fwachsmuth/ErnoCCC/Schematics/MCP4725.png

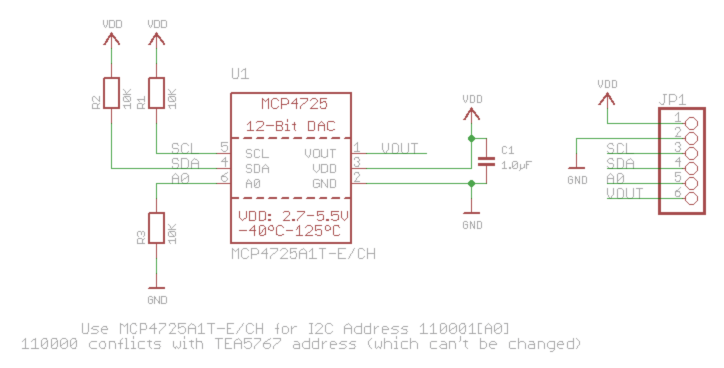
Schematics/MCP4725.png
