fwachsmuth/ErnoCCC/ErnoCCC-Kicad/ErnoCCC.kicad_pcb

## KiCad design ErnoCCC-Kicad/ErnoCCC.kicad_pcb (2023-11-20)

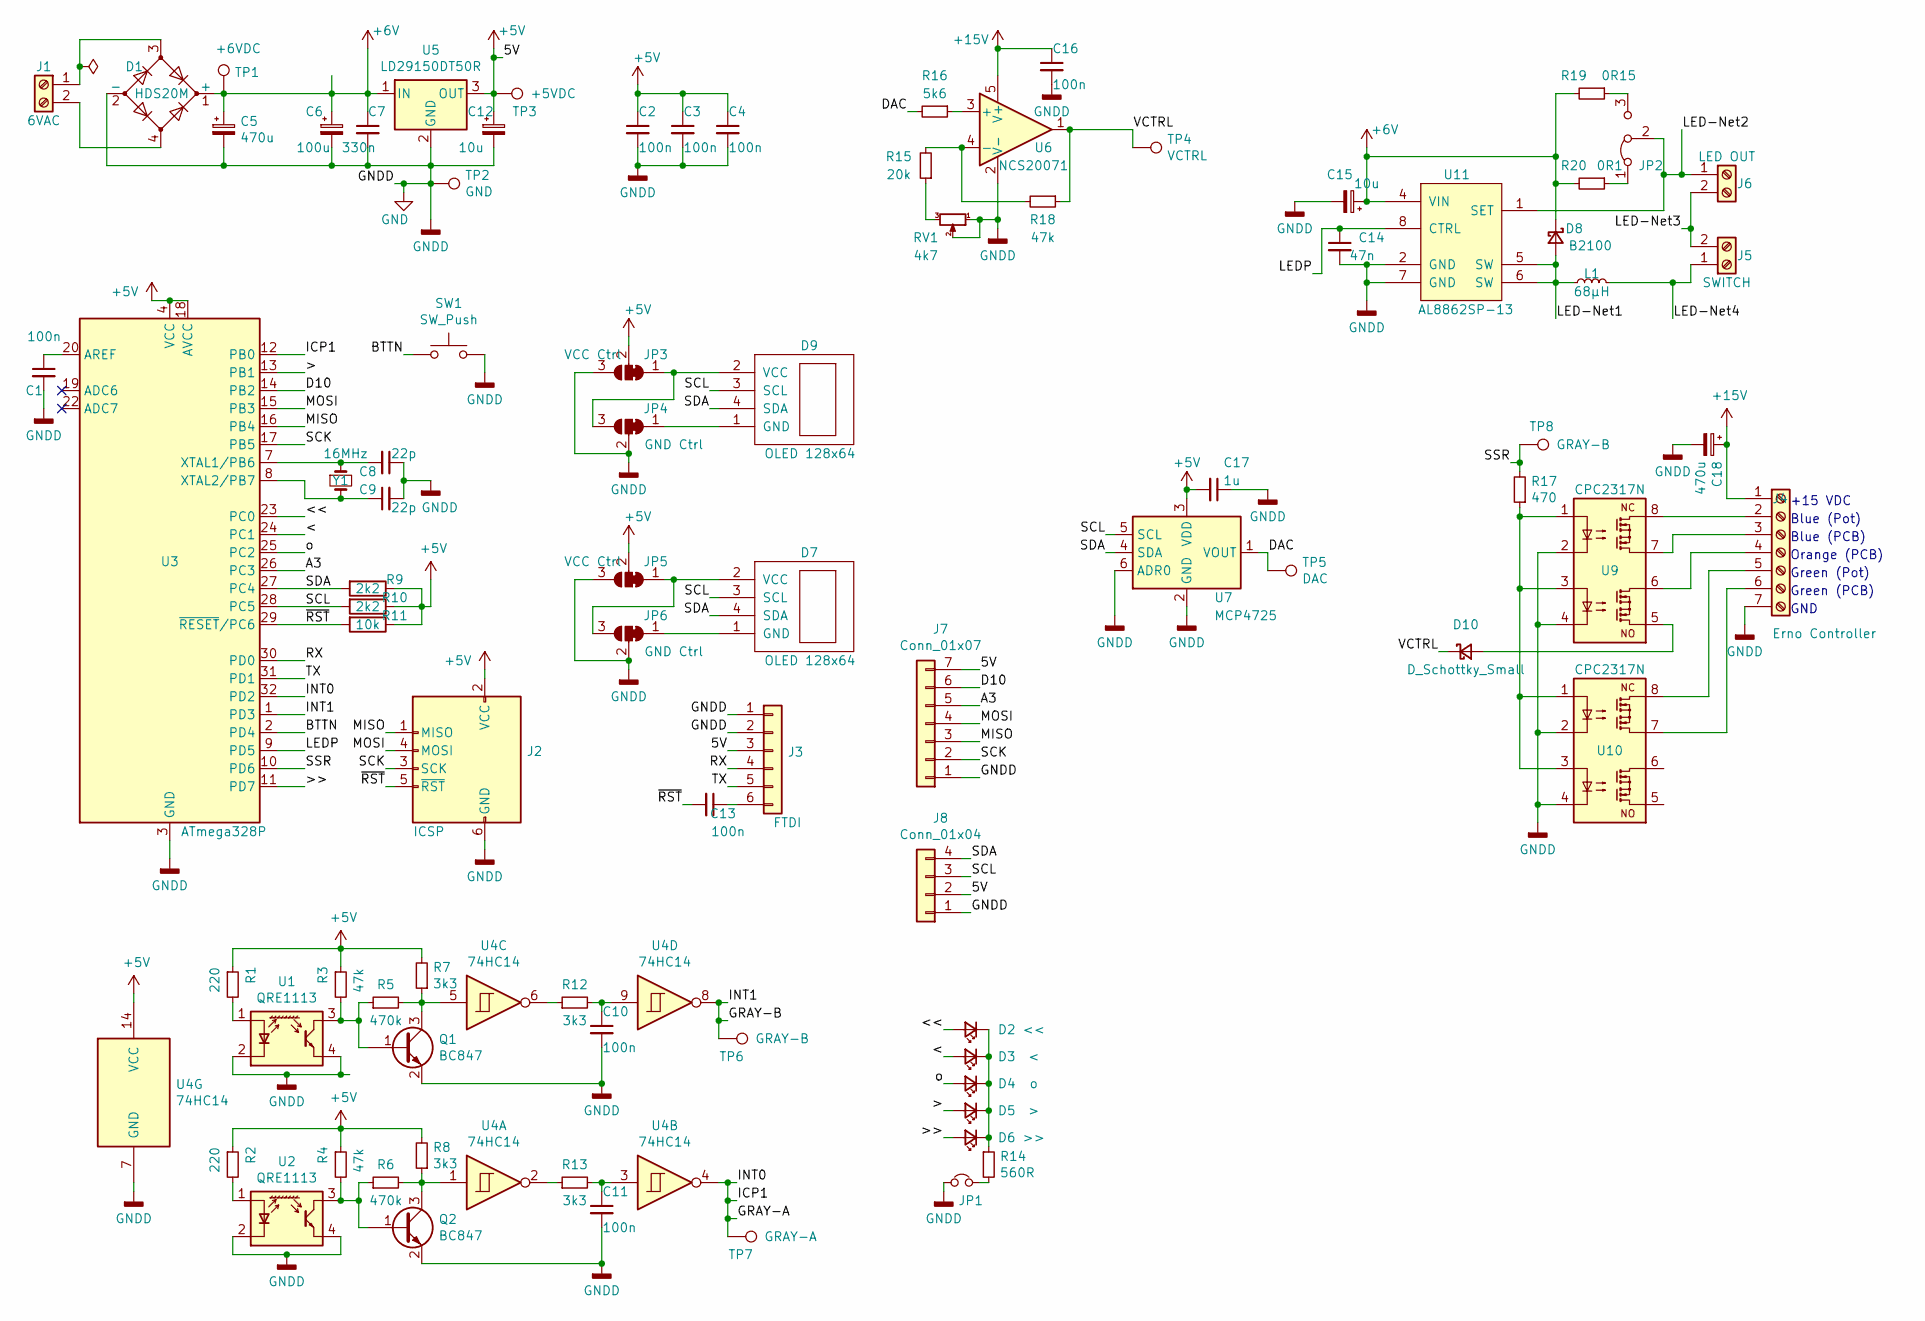
[picture p2: schematic ErnoCCC.kicad_sch]

Parts:
C1, C2, C3, C4, C10, C11, C13, C16: 100n; C_0805_2012Metric
C5, C18: 470u; CP_Elec_10x10
C6: 100u; CP_Elec_8x10.5
C7: 330n; C_0805_2012Metric
C8, C9: 22p; C_0805_2012Metric
C12, C15: 10u; CP_Elec_4x4.5
C14: 47n; C_0805_2012Metric
C17: 1u; C_0805_2012Metric
D1: HDS20M; HDS-4
D2: <<; LED_0805_2012Metric_Castellated
D3: <; LED_0805_2012Metric_Castellated
D4: o; LED_0805_2012Metric_Castellated
D5: >; LED_0805_2012Metric_Castellated
D6: >>; LED_0805_2012Metric_Castellated
D7: OLED 128x64; PinHeader_1x04_P2.54mm_Vertical
D8: B2100; D_SMB
D9: OLED 128x64; PinHeader_1x04_P2.54mm_Horizontal_shorter
D10: D_Schottky_Small; D_SMB
J1: 6VAC; TerminalBlock_bornier-2_P5.08mm
J2: ICSP; PinHeader_2x03_P2.54mm_Vertical
J3: FTDI; PinHeader_1x06_P2.54mm_Horizontal_shorter
J4: Erno Controller; TerminalBlock_Phoenix_MPT-0,5-7-2.54_1x07_P2.54mm_Horizontal
J5: SWITCH; TerminalBlock_bornier-2_P5.08mm
J6: LED OUT; TerminalBlock_bornier-2_P5.08mm
J7: Conn_01x07; PinSocket_1x07_P2.54mm_Vertical
J8: Conn_01x04; PinHeader_1x04_P2.54mm_Vertical
JP1: LED Jumper; PinHeader_1x03_P2.54mm_Vertical
JP2: R1 Select; SolderJumper-3_P1.3mm_Bridged2Bar12_Pad1.0x1.5mm
JP3, JP5: VCC Ctrl; SolderJumper-3_P1.3mm_Bridged12_RoundedPad1.0x1.5mm
JP4, JP6: GND Ctrl; SolderJumper-3_P1.3mm_Bridged12_RoundedPad1.0x1.5mm
L1: 68µH; L_10.4x10.4_H4.8
Q1, Q2: BC847; SOT-23
R1, R2: 220; R_0805_2012Metric
R3, R4, R18: 47k; R_0805_2012Metric
R5, R6: 470k; R_0805_2012Metric
R7, R8, R12, R13: 3k3; R_0805_2012Metric
R9, R10: 2k2; R_0805_2012Metric
R11: 10k; R_0805_2012Metric
R14: 560R; R_0805_2012Metric
R15: 20k; R_0805_2012Metric
R16: 5k6; R_0805_2012Metric
R17: 470; R_0805_2012Metric
R19: 0R15; R_1210_3225Metric
R20: 0R1; R_1210_3225Metric
RV1: 4k7; Potentiometer_Bourns_3296W_Vertical
SW1: SW_Push; SW_PUSH_6mm_H7.3mm
TP1: +6VDC; TestPoint_THTPad_D1.5mm_Drill0.7mm
TP2: GND; TestPoint_THTPad_2.0x2.0mm_Drill1.0mm
TP3: +5VDC; TestPoint_THTPad_D1.5mm_Drill0.7mm
TP4: VCTRL; TestPoint_THTPad_1.5x1.5mm_Drill0.7mm
TP5: DAC; TestPoint_THTPad_1.5x1.5mm_Drill0.7mm
TP6, TP8: GRAY-B; TestPoint_THTPad_1.5x1.5mm_Drill0.7mm
TP7: GRAY-A; TestPoint_THTPad_1.5x1.5mm_Drill0.7mm
U1, U2: QRE1113; QRE1113GR-slim
U3: ATmega328P; TQFP-32_7x7mm_P0.8mm
U4: 74HC14; SOIC-14_3.9x8.7mm_P1.27mm
U5: LD29150DT50R; TO-252-2
U6: NCS20071; TSOT-23-5
U7: MCP4725; SOT-23-6
U9, U10: CPC2317N; SOIC-8
U11: AL8862SP-13; SOIC-8-1EP_3.9x4.9mm_P1.27mm_EP2.41x3.81mm_ThermalVias
Y1: 16MHz; Crystal_SMD_Abracon_ABM3-2Pin_5.0x3.2mm

Connections:
+5V: C2.1, C3.1, C4.1, C12.1, C17.2, J2.2 (VCC), J3.3, J7.7, J8.2, JP3.2 (C), JP5.2 (C), R1.1, R2.1, R3.1, R4.1, R7.2, R8.2, R9.1, R10.1, R11.1, TP3.1, U3.4 (VCC), U3.6 (VCC), U3.18 (AVCC), U4.14 (VCC), U5.3 (OUT), U7.3 (VDD)
+6V: C5.1, C6.1, C7.1, C15.1, D1.1 (+), D8.1 (K), R19.2, R20.2, TP1.1, U5.1 (IN), U11.4 (VIN)
+15V: C16.1, C18.1, J4.1, U6.5 (V+)
/<: D3.2 (A), U3.24 (PC1)
/<<: D2.2 (A), U3.23 (PC0)
/>: D5.2 (A), U3.13 (PB1)
/>>: D6.2 (A), U3.11 (PD7)
/A3: J7.5, U3.26 (PC3)
/BTTN: SW1.1, U3.2 (PD4)
/D10: J7.6, U3.14 (PB2)
/DAC: R16.2, TP5.1, U7.1 (VOUT)
/GRAY-A: TP7.1, U3.12 (PB0), U3.32 (PD2), U4.4
/GRAY-B: TP6.1, U3.1 (PD3), U4.8
/LED-Net1: D8.2 (A), L1.1, U11.5 (SW), U11.6 (SW)
/LED-Net2: J6.1, JP2.2 (C), U11.1 (SET)
/LED-Net3: J5.2, J6.2
/LED-Net4: J5.1, L1.2
/LEDP: C14.1, U3.9 (PD5), U11.8 (CTRL)
/MISO: J2.1 (MISO), J7.3, U3.16 (PB4)
/MOSI: J2.4 (MOSI), J7.4, U3.15 (PB3)
/RX: J3.4, U3.30 (PD0)
/SCK: J2.3 (SCK), J7.2, U3.17 (PB5)
/SCL: D7.3 (SCL), D9.3 (SCL), J8.3, R10.2, U3.28 (PC5), U7.5 (SCL)
/SDA: D7.4 (SDA), D9.4 (SDA), J8.4, R9.2, U3.27 (PC4), U7.4 (SDA)
/SSR: R17.2, TP8.1, U3.10 (PD6)
/TX: J3.5, U3.31 (PD1)
/VCTRL: D10.1 (K), R18.1, TP4.1, U6.1
/o: D4.2 (A), U3.25 (PC2)
/~RST: C13.2, J2.5 (~RST), R11.2, U3.29 (~RESET/PC6)
GND: C1.2, C2.2, C3.2, C4.2, C5.2, C6.2, C7.2, C8.1, C9.2, C10.2, C11.2, C12.2, C14.2, C15.2, C16.2, C17.1, C18.2, D1.2 (-), J2.6 (GND), J3.1, J3.2, J4.7, J7.1, J8.1, JP1.1, JP3.3 (B), JP4.2 (C), JP5.3 (B), JP6.2 (C), Q1.2 (E), Q2.2 (E), RV1.1, RV1.2, SW1.2, TP2.1, U1.2 (K), U1.4, U2.2 (K), U2.4, U3.3 (GND), U3.5 (GND), U3.21 (GND), U4.7 (GND), U5.2 (GND), U6.2 (V-), U7.2 (GND), U7.6 (ADR0), U9.2, U9.4, U10.2, U10.4, U11.2 (GND), U11.7 (GND)
unnamed: C1.1, U3.20 (AREF)
unnamed: C8.2, U3.7 (XTAL1/PB6), Y1.1
unnamed: C9.1, U3.8 (XTAL2/PB7), Y1.2
unnamed: C10.1, R12.2, U4.9
unnamed: C11.1, R13.2, U4.3
unnamed: C13.1, J3.6
unnamed: D1.3, J1.1
unnamed: D1.4, J1.2
unnamed: D2.1 (K), D3.1 (K), D4.1 (K), D5.1 (K), D6.1 (K), R14.1
unnamed: D7.1 (GND), JP6.1 (A)
unnamed: D7.2 (VCC), JP5.1 (A), JP6.3 (B)
unnamed: D9.1 (GND), JP4.1 (A)
unnamed: D9.2 (VCC), JP3.1 (A), JP4.3 (B)
unnamed: D10.2 (A), U9.5
unnamed: J4.2, U9.8
unnamed: J4.3, U9.7
unnamed: J4.4, U9.6
unnamed: J4.5, U10.8
unnamed: J4.6, U10.7
unnamed: JP1.2, R14.2
unnamed: JP2.1 (A), R20.1
unnamed: JP2.3 (B), R19.1
unnamed: Q1.1 (B), R3.2, R5.1, U1.3
unnamed: Q1.3 (C), R5.2, R7.1, U4.5
unnamed: Q2.1 (B), R4.2, R6.1, U2.3
unnamed: Q2.3 (C), R6.2, R8.1, U4.1
unnamed: R1.2, U1.1 (A)
unnamed: R2.2, U2.1 (A)
unnamed: R12.1, U4.6
unnamed: R13.1, U4.2
unnamed: R15.1, RV1.3
unnamed: R15.2, R18.2, U6.4 (-)
unnamed: R16.1, U6.3 (+)
unnamed: R17.1, U9.1, U9.3, U10.1, U10.3

Notes on the sheet:
GND
+15 VDC
Green (PCB)
Blue (Pot)
Green (Pot)
Orange (PCB)
Blue (PCB)

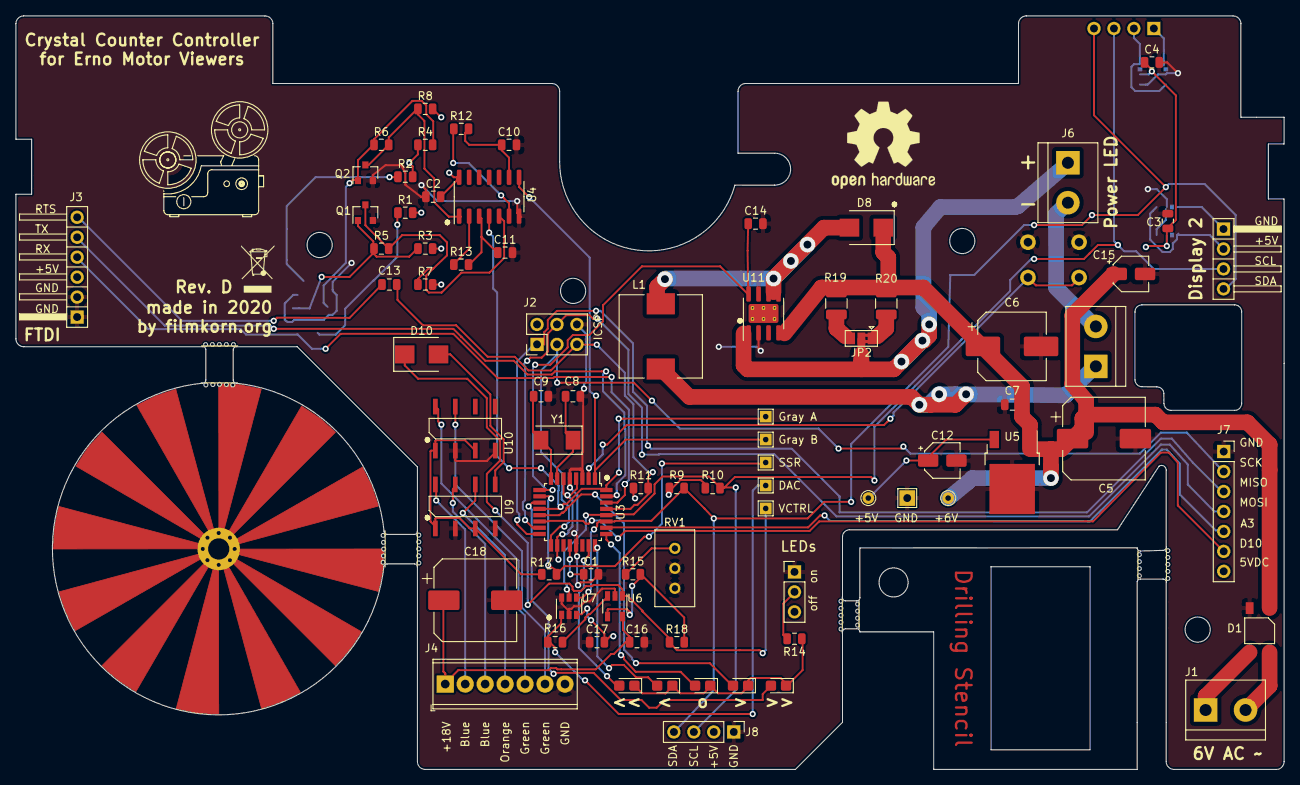
[picture p3: board ErnoCCC.kicad_pcb from above]

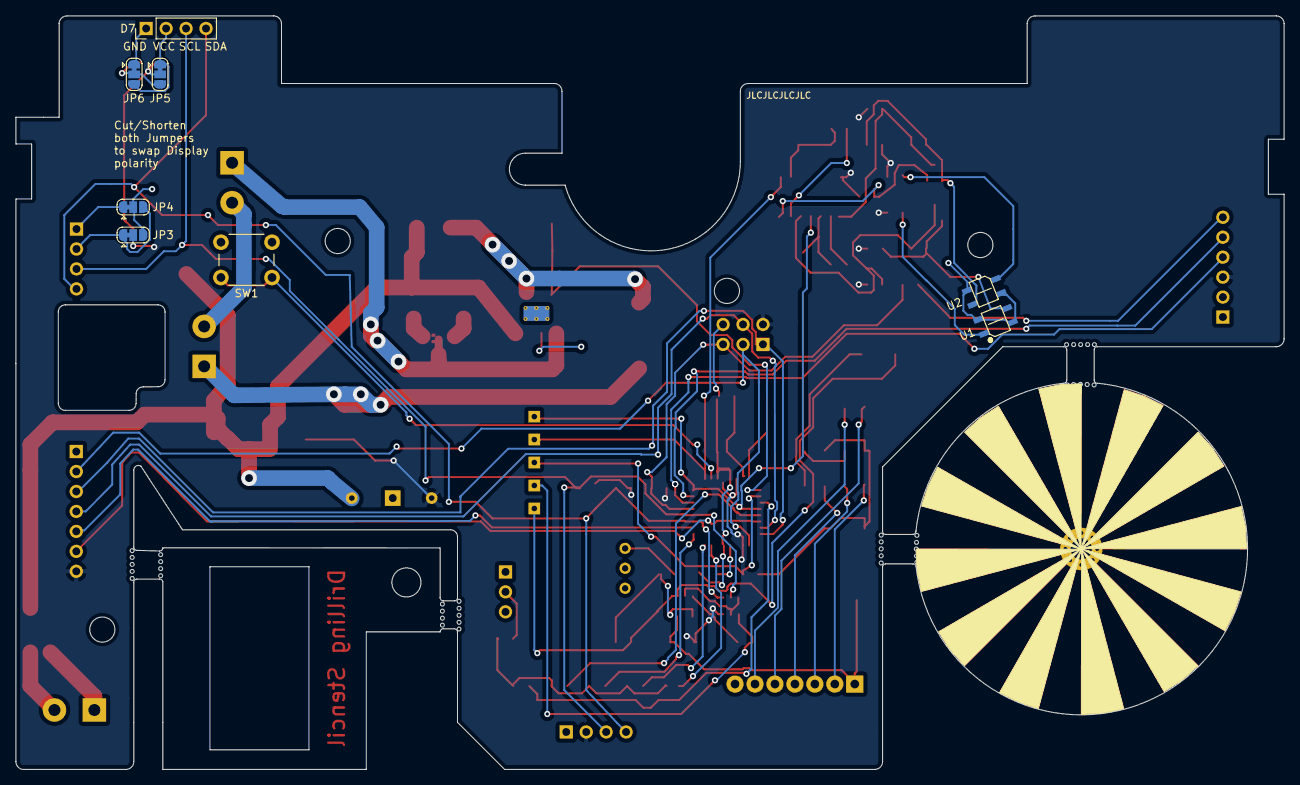
[picture p4: board ErnoCCC.kicad_pcb from below]

Board: 2 copper layers, 161.4 x 95.9 mm, 86 parts (8 on the bottom side), 64 nets.
