fwachsmuth/ErnoCCC/(commit log)

2019-12-28 KiCad Project
    [ErnoCCC.kicad_pcb, ErnoCCC.sch]
2019-12-28 Cleaning up Dir Structure
    [ErnoCCC.kicad_pcb, ErnoCCC.sch]
2019-12-29 Gerbers for Rev A
    [ErnoCCC-B_Cu.gbr, ErnoCCC-B_Mask.gbr, ErnoCCC-B_Paste.gbr, ErnoCCC-B_SilkS.gbr, ErnoCCC-Edge_Cuts.gbr, ErnoCCC-F_Cu.gbr, ErnoCCC-F_Mask.gbr, ErnoCCC-F_Paste.gbr]
2019-12-29 Cleaning up Kicad
    [ErnoCCC.sch]
2019-12-30 Adding a D10 Breakout for later Vectrol (or MOSFET) experiments
    [ErnoCCC.kicad_pcb, ErnoCCC.sch]
2019-12-30 Adding TPs to a Header, fixing disconnected GND planes
    [ErnoCCC-B_Cu.gbr, ErnoCCC-B_Mask.gbr, ErnoCCC-B_Paste.gbr, ErnoCCC-B_SilkS.gbr, ErnoCCC-Edge_Cuts.gbr, ErnoCCC-F_Cu.gbr, ErnoCCC-F_Mask.gbr, ErnoCCC-F_Paste.gbr]
2019-12-30 Create a little jittering GRAY-Code Generator to simulate viewer movenment
    [CreateGray.ino, ErnoCCC.ino]
2019-12-31 SMPTE Display works, but is a tad too slow @ 7.7 fps
    [ErnoCCC.ino]
2019-12-31 Fixing I2C Pullups Rs, removing invalid Gerbers
    [ErnoCCC-B_Cu.gbr, ErnoCCC-B_Mask.gbr, ErnoCCC-B_Paste.gbr, ErnoCCC-B_SilkS.gbr, ErnoCCC-Edge_Cuts.gbr, ErnoCCC-F_Cu.gbr, ErnoCCC-F_Mask.gbr, ErnoCCC-F_Paste.gbr]
2020-01-01 Updating to bigger (and curved) MouseBites to match JLCPCB's DRCs
    [ErnoCCC.kicad_pcb]
2020-01-01 Added “Stopped” and “Running” states Changed a lot of other stuff
    -Kalle
2020-01-02 Implemented correct way of handling 16 2/3 fps subframes
    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
    [ErnoCCC.ino]
2020-01-02 Reset by long press in stopped mode Less rewriting the time Fixed bugs
    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
    [ErnoCCC.ino]
2020-01-02 Fixing i2c bus, making OLED polarity conifgurable, submitting final ReV gerbers
    [ErnoCCC-B_Cu.gbr, ErnoCCC-B_Mask.gbr, ErnoCCC-B_Paste.gbr, ErnoCCC-B_SilkS.gbr, ErnoCCC-Edge_Cuts.gbr, ErnoCCC-F_Cu.gbr, ErnoCCC-F_Mask.gbr, ErnoCCC-F_Paste.gbr]
2020-01-02 Idling in the reset counter menu will hide it again A counter change will also hide it 9 fps has only one digit Added compiler macros Decreased the time redraws
    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
    [ErnoCCC.ino]
2020-01-02 Adding original Erno Controller Schematics
    [ErnoController.sch]
2020-01-05 Schema Refactoring in progress...
    [ErnoCCC.sch]
2020-01-11 preparing for rev b
    [ErnoCCC.sch]
2020-01-12 Preparing for the big refactoring (old footprints still there)
    [ErnoCCC.kicad_pcb, ErnoCCC.sch]
2020-01-12 Preparing for the big RevB rerouting
    [ErnoCCC.kicad_pcb, ErnoCCC.sch]
2020-01-14 Adding a 15VDC Elko
    [ErnoCCC.kicad_pcb, ErnoCCC.sch]
2020-01-15 Reduced Footprint size of C12 and C15 Eliminated upper right slot for flatter PCB mounting Made the bottom right cutout 2.5mm bigger to have less stress on the viewer's mirror when mounting the PCB
2020-01-15 Updating the Pin Header Length (6x done, 4x and 7x to follow)
    [ErnoCCC.kicad_pcb, ErnoCCC.sch]
2020-01-16 Updating QRE1113 footrpint
    [ErnoCCC.kicad_pcb]
2020-01-16 Smaller Header footprint for 4 & 5 pin connectors
    [ErnoCCC.kicad_pcb]
2020-01-16 Correcting Display Position
    [ErnoCCC.kicad_pcb]
2020-01-16 Fixing Schematics Bugs, PCB progress
    [ErnoCCC.kicad_pcb, ErnoCCC.sch]
2020-01-16 Spreading out parts
    [ErnoCCC.kicad_pcb, ErnoCCC.sch]
2020-01-16 Re-Routed 99%
    [ErnoCCC.kicad_pcb]
2020-01-17 Wiring it all up
    [ErnoCCC.kicad_pcb]
2020-01-17 More wires
    [ErnoCCC.kicad_pcb]
2020-01-17 DRC green!
    [ErnoCCC.kicad_pcb]
2020-01-17 Fixing Encoder Direction, improving Silkscreen
    [ErnoCCC.kicad_pcb]
2020-01-17 Ready for Rev.C
    [ErnoCCC.kicad_pcb]
2020-01-18 Adding fidicules for the stencil
    [ErnoCCC.kicad_pcb]
2020-01-18 dding a negative outline PCB for easier solder paste application
    [PCB-Negative.kicad_pcb]
2020-01-18 Rounding Corners, making fidicules actually match
    [ErnoCCC.kicad_pcb, PCB-Negative.kicad_pcb]
2020-01-18 Rounding some corners
    [PCB-Negative.kicad_pcb]
2020-01-18 Rev.B as ordered
    [ErnoCCC-B_Cu.gbr, ErnoCCC-B_Mask.gbr, ErnoCCC-B_Paste.gbr, ErnoCCC-B_SilkS.gbr, ErnoCCC-Edge_Cuts.gbr, ErnoCCC-F_Cu.gbr, ErnoCCC-F_Mask.gbr, ErnoCCC-F_Paste.gbr]
2020-01-18 Board validations while waiting fro RevB to ship
2020-01-19 Fixing the Frequency Display
    [ErnoCCC.ino]
2020-01-19 Trying to fix the missing solder mask on the stencil board probably still needs a net though
    [PCB-Negative-B_Cu.gbr, PCB-Negative-B_Mask.gbr, PCB-Negative-B_Paste.gbr, PCB-Negative-B_SilkS.gbr, PCB-Negative-Edge_Cuts.gbr, PCB-Negative-F_Cu.gbr, PCB-Negative-F_Mask.gbr, PCB-Negative-F_Paste.gbr]
2020-01-19 Trying to fix the button
    [ErnoCCC.ino]
2020-01-20 Fixing the 16.66 Eprom bug
    [ErnoCCC.ino]
2020-01-24 New BOM
2020-02-01 Freezing last state before getting into motor control
2020-02-01 Auto Calibrate 0.1! :)
2020-02-02 Extrapolate Ctrl Voltages after determining just two voltages
2020-02-02 Added EEPROM Calibration saving
2020-02-02 Trying to debug why regulation doesn't work
    [ErnoCCC.ino]
2020-02-02 Fixed the reflection glitch on GRAY-A, found out that the projector counter counts only half as fast as the timer. Temp fixed by double increments
    [ErnoCCC.ino]
2020-02-17 Dis lookin good. Opamp swapped.
    [ErnoCCC.ino]
2020-02-23 Preparing RevC. One Diode still missing
    [ErnoCCC.kicad_pcb]
2020-02-23 Fixed Exe Distance, fixed Display Position, fixed missing i2c on DAC, added Diode to Motor Out, Added labels to pinouts, removed Peephole LED
    [ErnoCCC.kicad_pcb, ErnoCCC.sch]
2020-02-23 Adding comments re how to calibrate the trimpot (new R15 value needed!)
2020-02-23 Gute Nacht
    [ErnoCCC.kicad_pcb, ErnoCCC.sch]
2020-02-24 Updating Connectors for RevC
    [ErnoCCC.sch]
2020-02-24 Adding all the Improvements: SPI, TPs for DAV, VCTRL, SSR, GRAY. Also, GND and VCC on J7
    [ErnoCCC.sch]
2020-02-25 Adding I2C on a pinheader
    [ErnoCCC.kicad_pcb, ErnoCCC.sch]
2020-02-25 RevC: Done!
    [ErnoCCC.kicad_pcb, ErnoCCC.sch]
2020-02-25 Gerbers for Rev C
    [ErnoCCC-B_Cu.gbr, ErnoCCC-B_Mask.gbr, ErnoCCC-B_Paste.gbr, ErnoCCC-B_SilkS.gbr, ErnoCCC-Edge_Cuts.gbr, ErnoCCC-F_Cu.gbr, ErnoCCC-F_Mask.gbr, ErnoCCC-F_Paste.gbr]
2020-03-07 Pins have changed in RevC. Fixing this here
    [ErnoCCC.ino]
2020-03-07 Fixing the short in the LEDs :(
    [ErnoCCC.sch]
2020-03-07 Fixing all the GND plane errors
    [ErnoCCC.kicad_pcb]
2020-03-07 More cleanup, better ground planes
    [ErnoCCC.kicad_pcb]
2020-03-07 Adding Trimpot calibration mode
2020-03-07 Fixing some silkscreen
    [ErnoCCC.kicad_pcb]
2020-03-07 Adding Status Display for Calibration Mode
2020-03-08 Speed Calibration now happening by pushing the button and turning on the motor
2020-03-08 Calibration becoming nice.
2020-03-08 Updating the Display after calibration
2020-03-08 Adding some LED feedback to the calibration process
2020-03-08 Fixing Reset! (Kalle ftw)
    [ErnoCCC.ino]
2023-11-20 Kicad 6 files, .gitignore
    [ErnoCCC.kicad_pcb, ErnoCCC.kicad_sch]
2023-11-20 Removing KiCad backup stuff
